IZKNakhil/ESP32-ESP8266-Hand-Controlled-Robot-Car/ESP32-ESP8266-Hand-Controlled-Robot-Car/docs/hardware.md

# Hardware

The project consists of two physical units: a handheld ESP32/HC-SR04 controller and a four-wheel ESP8266/L298N robot car.

See the root README for the bill of materials and original build photographs.
